RujoiRazvan/sistemAutomatDeIrigatie/README.md

# Sistem Automat de Irigatie
Proiect Informatică Aplicată II

Sistem Automat de Irigatie | Arduino

Componente utilizate
•	Arduino UNO

•	1 x Breadboard

•	Display Nokia 5110

•	Releu 5V Keyes

• Pompă submersibilă de apă 5V

•	Senzor de temperatură și umiditate DHT11

•	Senzor umiditate sol YL-69

•	Buzzer

•	Buton

•	Led Roșu 5mm

•	Rezistenta 10 kohm (albastra)

•	Rezistenta 200 ohm (albastra, la led)

•	Rezistenta 218 ohm (maro)

•	Modul NodeMcu WIFI ESP 8266 V3.0 (intreg proiectul poate fi realizat doar cu acest microcontroller, fara a mai folosi si Arduino Uno)

•	Cabluri mama – mama

•	Cabluri tata - tata

•	Cabluri mama – tata

•	Opțional – doză electrică 

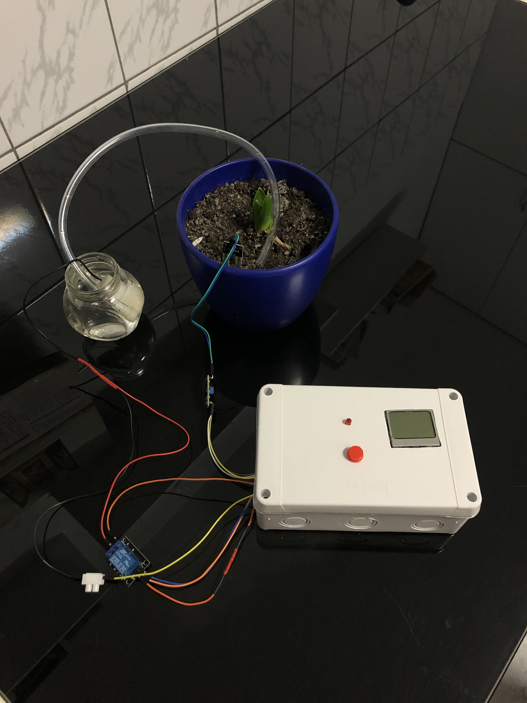
[picture p1: Poze proiect/2020-12-09 18.13.12 IMG_5424.JPG]
