RujoiRazvan/sistemAutomatDeIrigatie/Prezentare proiect.pdf

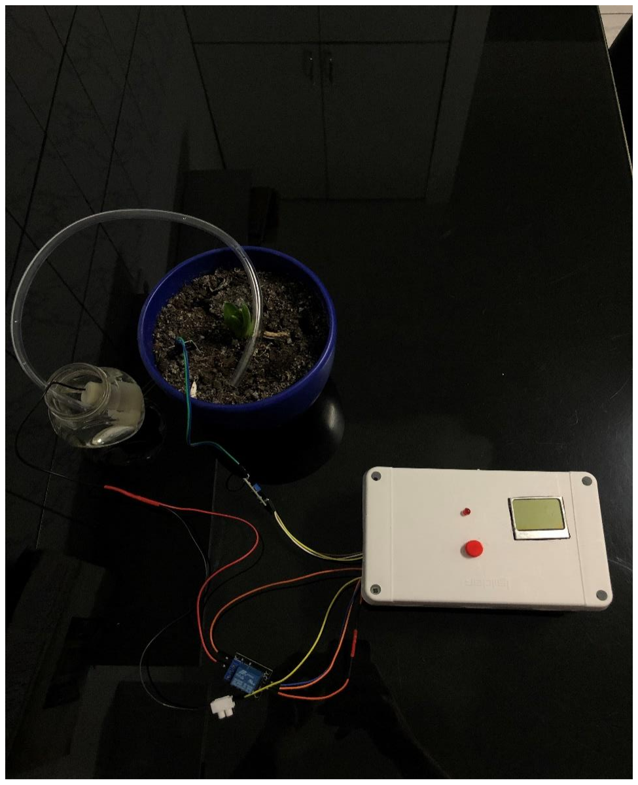
[picture p2: figure]

# Sistem automat de irigat

### ~ARDUINO UNO~

Rujoi Răzvan | Informatică Aplicată II | 31.10.2020

## Cuprins

## Componente utilizate

- Arduino UNO
- 1 sau 2 breadboard-uri
- Display Nokia 5110
- Releu 5V Keyes
- Pompă submersibilă de apă 5V
- Senzor de temperatură și umiditate DHT11
- Senzor umiditate sol YL-69
- Buzzer
- Buton
- Led Roșu 5mm
- Rezistență 10 kohm (albastră)
- Rezistență 200 ohm (albastră, la led)
- Rezistență 218 ohm (maro)
- Modul NodeMcu WIFI ESP 8266 V3.0
- Cabluri mamă – mamă
- Cabluri tată - tată
- Cabluri mamă – tată
- Opțional – doză electrică

Preț estimativ: 117lei.

## Utilitatea proiectului

Majoritate cred că avem flori sau ceva plante acasă, care trebuie udate. Problema e atunci când plecăm o perioadă mai lungă de acasă. M-am gândit să fac acest proiect cu scopul de a putea uda plantele de la distanță sau automat, la un anumit interval de timp, în funcție de umiditatea solului si de ce nu, si printr-o simplă apăsare a unui buton.

Pentru a putea adăuga proiectul intr-o carcasă, m-am decis să folosesc două breadbord-uri pentru a nu înghesui toate componentele pe o singură bază de construcție (breadboard). La un breadboard conectez senzorii iar la celălalt conectez tot ce ține de ieșirea datelor (display, led, difuzor), dar si butonul...care atunci când e apăsat, transmite un impuls electric și astfel pornește pompa

Aici (https://github.com/RujoiRazvan/sistemAutomatDeUdatPlante) se poate găsi întregul proiect .

## Realizarea proiectului

1. CONECTAREA TUTUROR COMPONENTELOR

Începem cu legarea GND-ului si VCC-ului (5V în cazul nostru) la primul breadboard. Pe tot parcusul proiectului am folosit acealeași culori pentru GND si VCC, mai exact negru respectiv roșu.

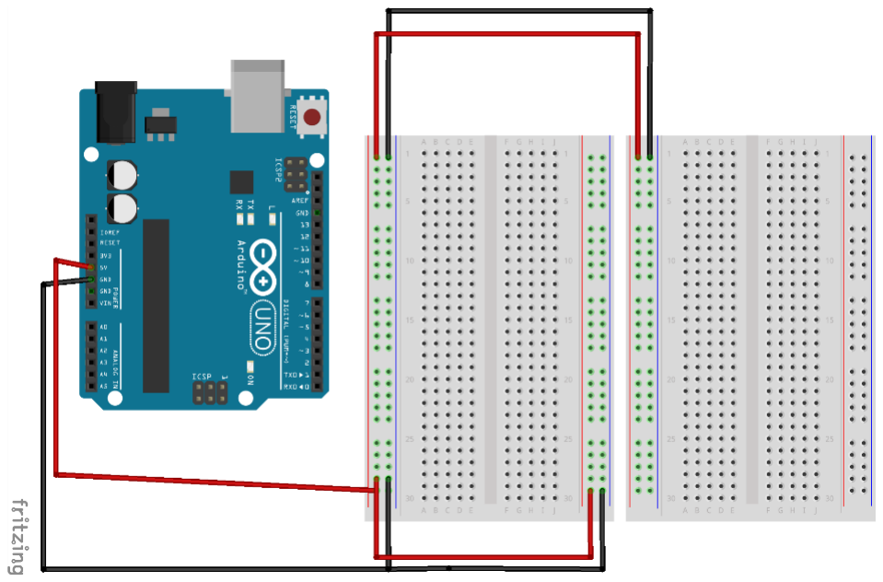
[picture p3: figure]

O să continuăm cu adăugarea senzorilor (la primul breadboard).

Conectăm senzorul DHT11. Acesta are 3 pini: GND, VCC si S. Primii doi pini se conectează la fel ca în cazul breadboard-ului iar pinul S, cel care transmite datele către Arduino se conectează la pinul Digital nr. 2 de pe Arduino (cablul alb).

Figura 1.0

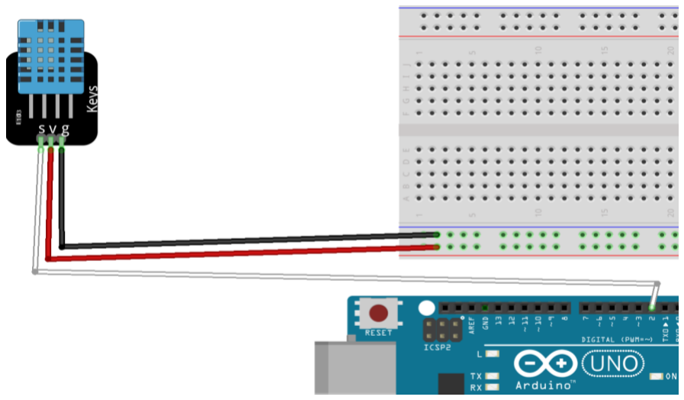
[picture p4: figure]

Figura 1.1

Conectăm buzzer-ul. Acesta are doar 2 pini: GND și VCC. Pentru a putea controla când să pornească, o să conectăm VCC-ul la pinul Digital nr. 6 astfel: conectăm VCC-ul la un pin de pe breadboard iar la un pin aflat pe aceeași linie, conectăm un alt cablu care o sa meargă la pinul Digital nr. 6.

GND-ul o să-l conectăm folosind o rezistență de 218 ohm.

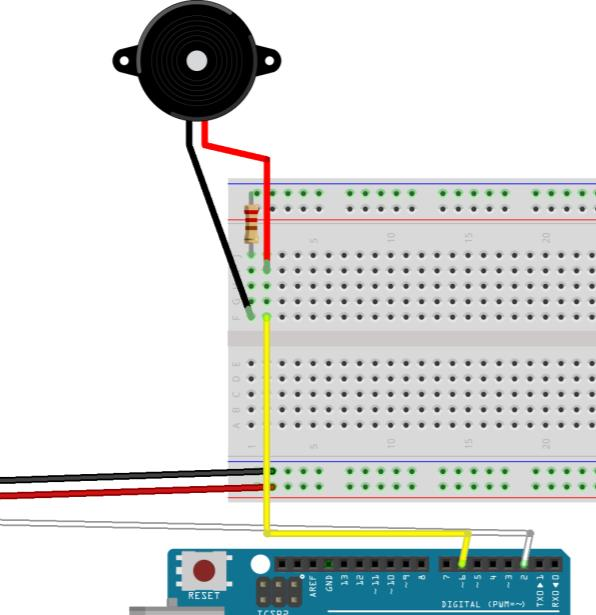
[picture p5: figure]

Senzorul de umiditate a solului are 4 pini. VCC-ul si GND-ul se conecteaza la breadboard iar pinul de semnal (eu am ales pinul pentru semnal Analog) il conectez la pinul A0 de pe Arduino.

Pompa de apă trebuie conectată folosind un releu și tot odată trebuie conectată la o sursă de curent (în cazul meu, o baterie de 9V) .Minisul îl conectăm direct la baterie iar plusul îl conectăm la portul NO (Normally Open).

Acum urmează să conectăm releul la Arduino. De data aceasta am conectat releul direct la Arduino pentru că l-am conectat direct la breadboard dar apoi nu imi mai mergea display-ul. VCC-ul l-am conectat la 5V, GND-ul la GND și pinul S (de la Signal) l-am conectat la pinul Digital nr. 4, dar folosind și o rezistență de 10 kohm. Am folosit acea rezistență deoarece atunci când porneam pompa, Arduino-ul se reseta sau pompa nu mergea așa cum trebuia. (vezi video) (https://youtu.be/gzFHKmYkRg8)

Figura 1.2

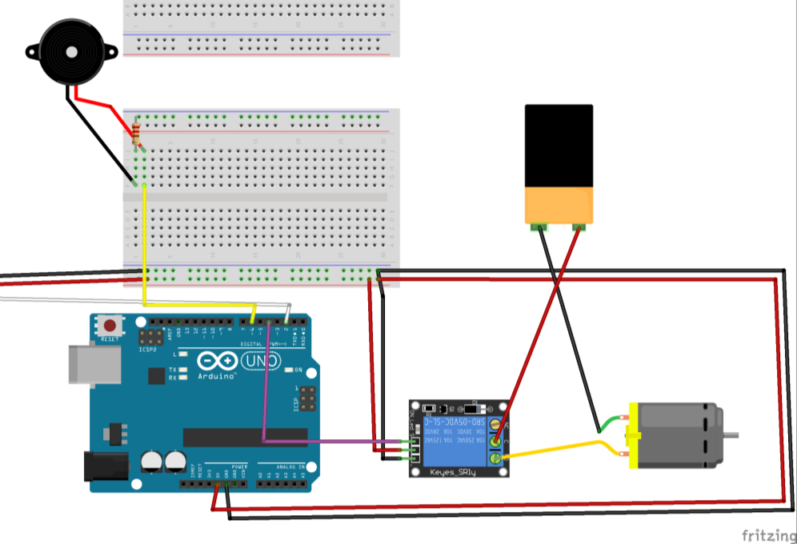
[picture p6: figure]

Figura 1.3

Acum urmează să lucrăm la cel de al doilea breadboard.
O să începem cu conectarea display-ului de Nokia 5110. Este un display 84x48. Display-ul are 8 pini. VCC-ul si GND-ul se conectează ca până acum. Aproape toate legăturile le-am făcut folosind primul breadboard pentru a putea manipula cât mai ușor breadboardul cu display-ul, butonul etc.. Backlight-ul l-am conectat tot la GND, dar folosind o rezistență de 10 kohm. Restul pinilor i-am conectat astfel:
- SCE – pinul 9
- RST – pinul 8
- D/C – pinul 10
- DN – pinul 11
- SCLK – pinul 12

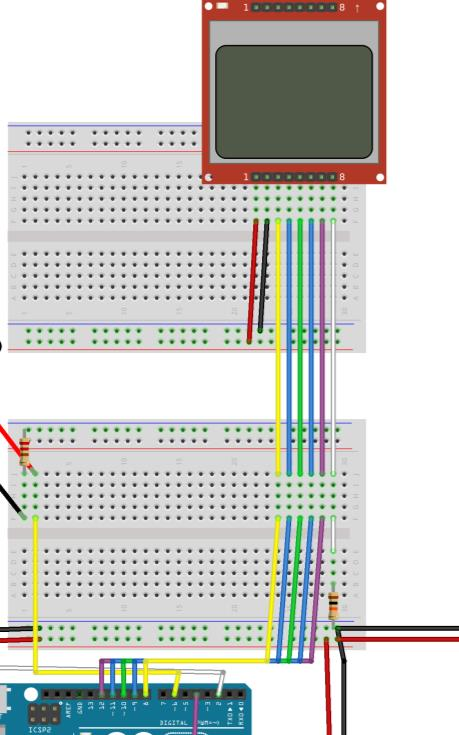
[picture p7: figure]

Figura 1.4

Mai adăugăm un led, eu am ales unul roșu de 5mm și un buton (de tipul push button) de la care pornim manual pompa.

Led-ul îl conectăm foarte ușor. Catodul (piciorușul mai scurt) îl conectăm la GND. Anodul (piciorușul mai lung) il conectăm la pinul Digital nr. 7, prin intermediul breadboardului 1 dar si la VCC, de data aceasta folosind o rezistență de 200 ohm pentru a nu-l arde. Led-ul de 5mm funcționează la un voltaj intre 1.8V si 2.4V. Noi având breadboardul conectat la 5V, avem nevoie de o rezistență pentru a limita cantitatea de curent care trece prin el si astfel prelungindui durata de viață (cu această rezistență am pe led o tensiune de 1.93V).

Butonul l-am conectat la GND cu o rezistență de 10kohm pentru a nu prelua orice impuls mic de curent care ar fi pornit pompa de apă. De la același pin al butonului, am dus un fir la pinul Digital nr. 5.

Ultima componentă care trebuie conectată e modulul wifi NodeMcu V3, cu ajutorul căruia o să pornim pompa de apă prin wifi sau. Îl conectăm la VCC folosind pinul 3.3V de pe modul, din care ducem un fir la + ul de pe breadboard, iar GND-ul la – ul de pe breadboard. Din pinul D2 ducem un fir la pinul butonului (vezi schema). Pentru a afișa temperatura in aplicația Blynk, am tras un fir de la Signal (DHT11) la pinul D4 de pe NodeMcu.

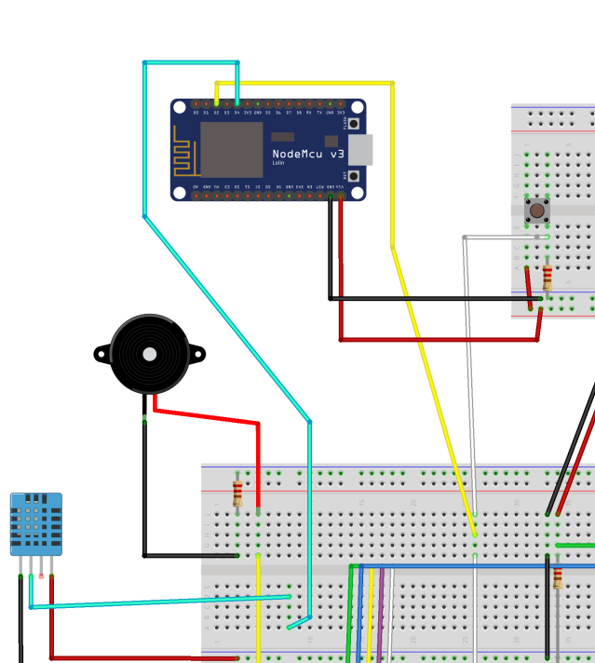
[picture p8: figure]

Figura 1.5

P.S.: Am renunțat la breadbordul nr. 2 pentru a putea lipi lcd-ul, led-ul si butonul pe aceea carcasă.

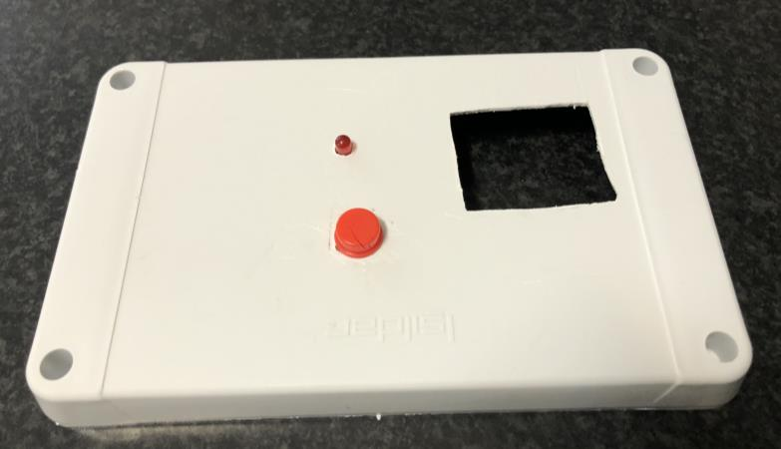
[picture p9: figure]

Prin urmare, am lipit rezistența direct pe led iar pe buton am lipit două fire.

Capac carcasă

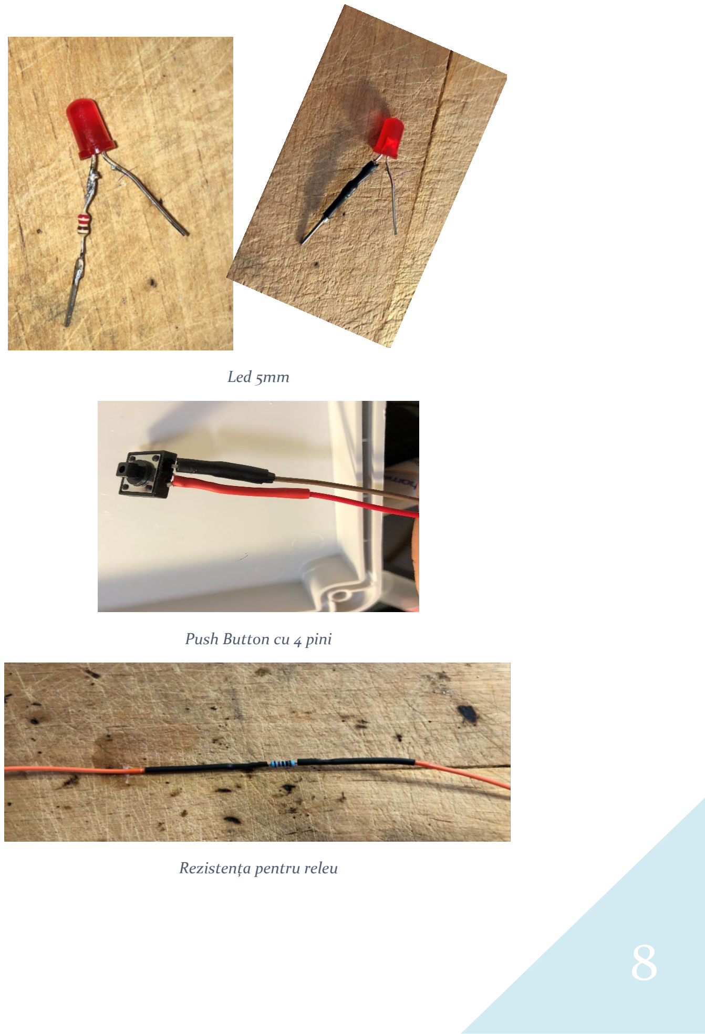
[picture p10: page 9]

Led 5mm

Push Button cu 4 pini

Rezistența pentru releu

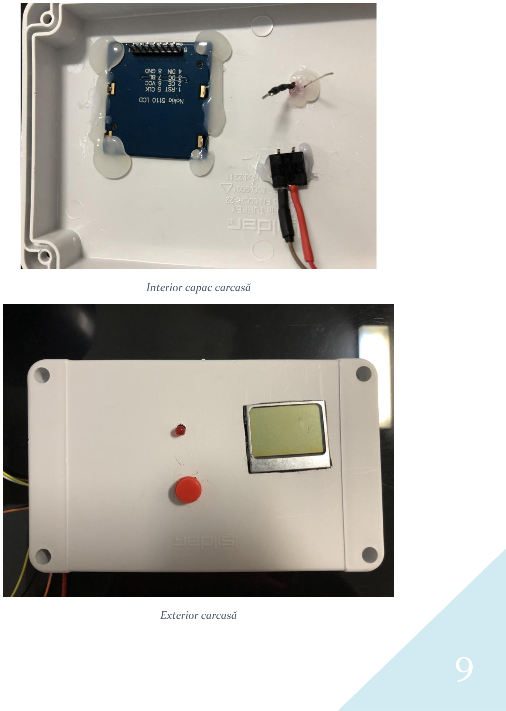
[picture p11: page 10]

Interior capac carcasă

Exterior carcasă

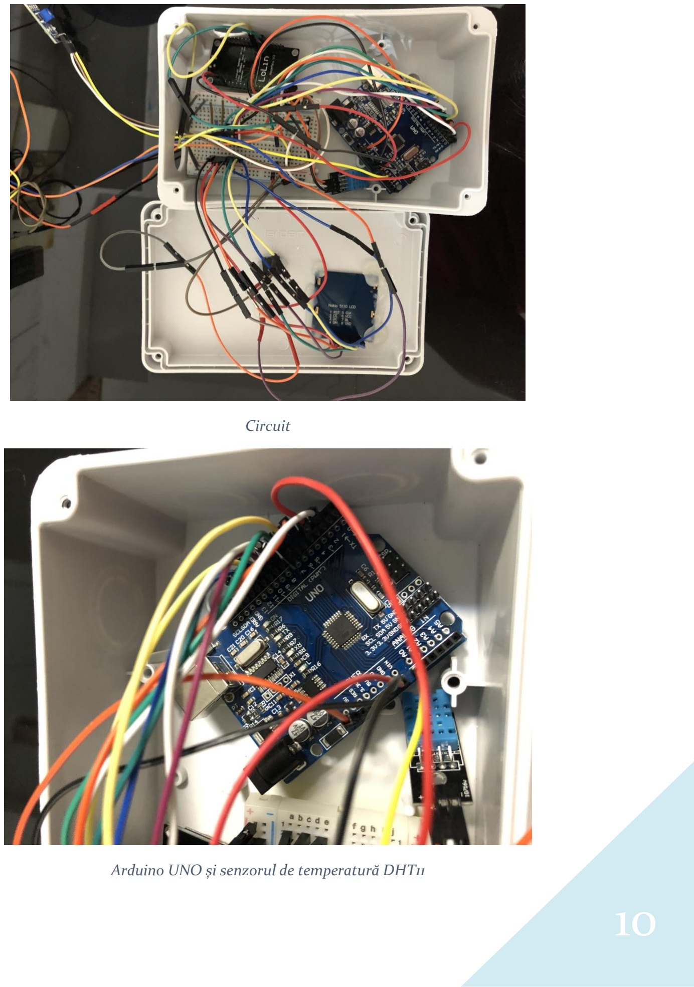
[picture p12: page 11]

Circuit

Arduino UNO și senzorul de temperatură DHT11

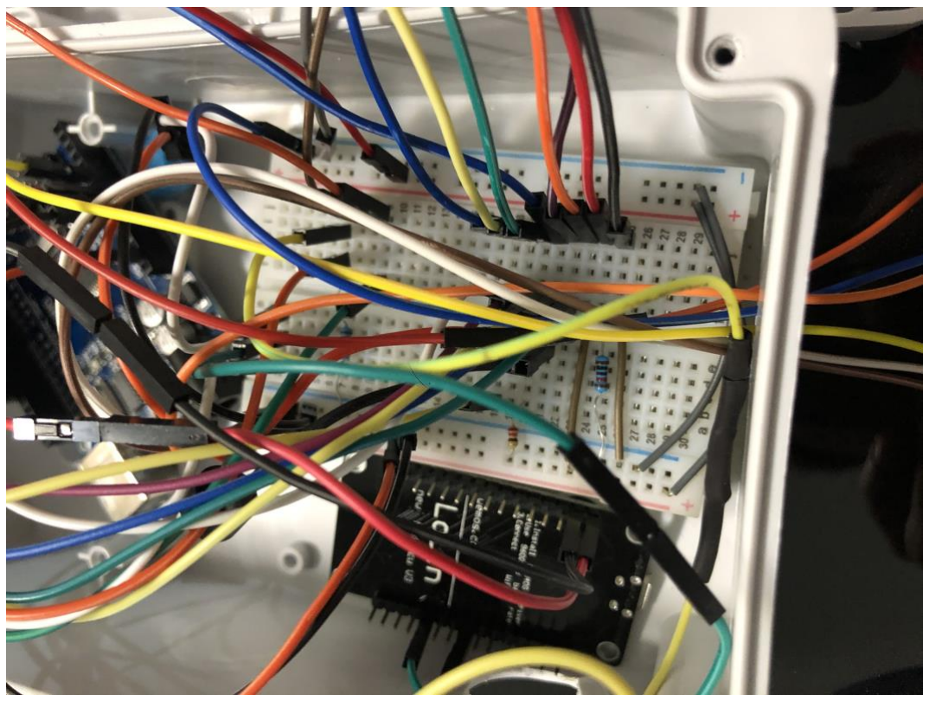
[picture p13: figure]

Modul Wifi NodeMCU V3.0 și breadboard

2. SCRIEREA CODULUI

Prima dată trebuie să instalăm Arduino IDE (https://www.arduino.cc/en/software).

O să începem prin adăugarea librăriilor. Avem nevoie doar de două librării:

- pentru display-ul Nokia 5110 (https://github.com/RujoiRazvan/sistemAutomatDeUdatPlante/blob/main/Adafruit-PCD8544-Nokia-5110-LCD-library-master.rar)
- pentru senzorul de temperatură DHT11 (https://github.com/RujoiRazvan/sistemAutomatDeUdatPlante/blob/main/DHTlib.rar)

Programul e structurat in două funcții: setup() și loop().

În setup() facem pinilor și inițializarea display-ului pentru prima pornire.

În funcția loop() scriem comenziile pe care vrem ca Arduino să le execute în mod repetitiv.

Vizualizează codul (https://github.com/RujoiRazvan/sistemAutomatDeUdatPlante/blob/main/Sistem_Automat_de_Udat_Plante.ino)

Pentru a putea controla pompa de pe telefon, avem nevoie să programăm modulul Wifi NodeMCU ESP8266 V3.0. Acest modul poate fi folosit și standalone dar aici îl folosim pentru a activa butonul fizic, care e legat la Arduino iar astfel se execute toate celălalte comenzi. Codul l-am generator automat pe acest (https://examples.blynk.cc/?board=ESP8266&shield=ESP8266%20WiFi&example=More%2FDHT11) site. Apoi am instalat aplicația Blynk pe telefon, am creat un proiect și am primit pe mail un autentificator pe care l-am adăugat în programul generat.

Vizualizează codul (https://github.com/RujoiRazvan/sistemAutomatDeUdatPlante/blob/main/ESP8266_Standalone.ino)

## Videoclipuri

- Pornire pompă de la buton (https://youtu.be/zWD_Jf1BwbU)
- Pornire pompă prin aplicația Blynk (https://youtu.be/5VBfaCA5-UU)
- Modificarea umidității solului (https://youtu.be/xtvZwhrjj-I)

## Bibliografie

- https://lastminuteengineers.com/nokia-5110-lcd-arduino-tutorial/
- https://www.instructables.com/Simple-Led-Control-With-Blynk-and-NodeMCU-Esp8266-/ (https://www.instructables.com/Simple-Led-Control-With-Blynk-and-NodeMCU-Esp8266-/)
- https://www.youtube.com/watch?v=udmJyncDvw0&ab_channel=AndreasSpiess
- https://www.instructables.com/Arduino-Soil-Moisture-Sensor/
- https://forum.arduino.cc/
