RujoiRazvan/sistemAutomatDeIrigatie/Poze proiect/2020-12-09 18.10.22 IMG_5423.JPG

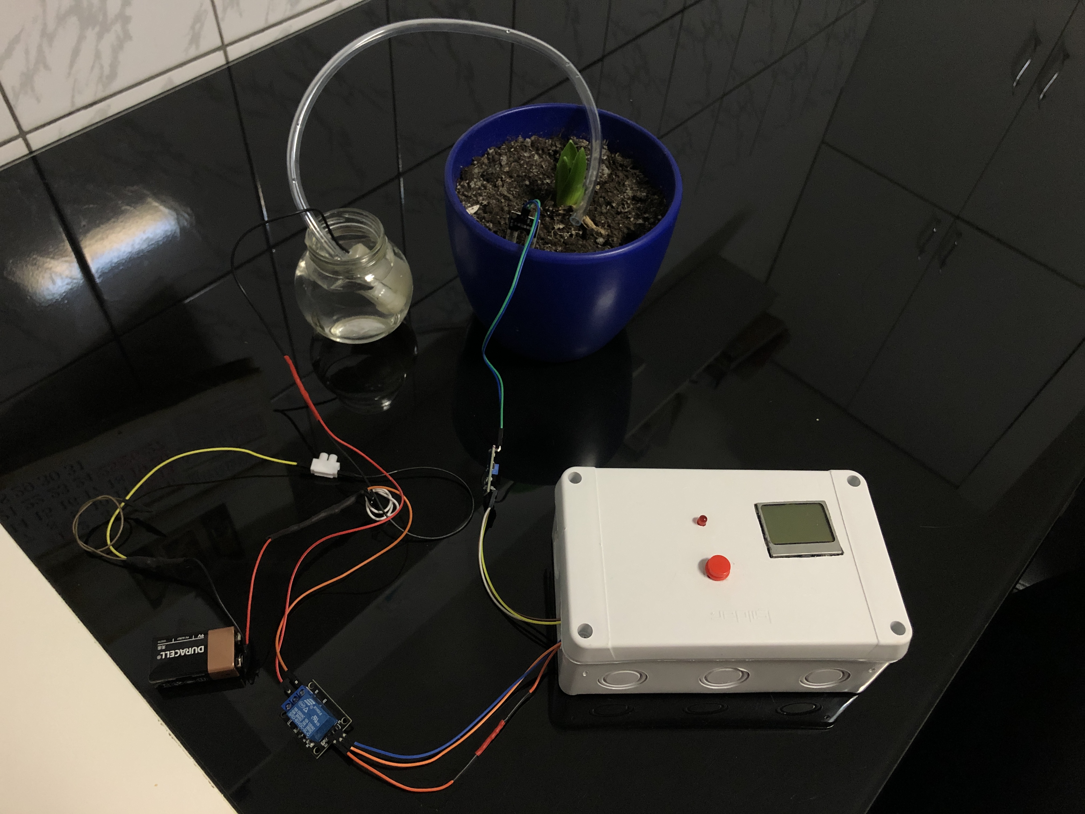
Poze proiect/2020-12-09 18.10.22 IMG_5423.JPG
