RujoiRazvan/sistemAutomatDeIrigatie/Poze proiect/2020-12-09 18.13.24 IMG_5425.JPG

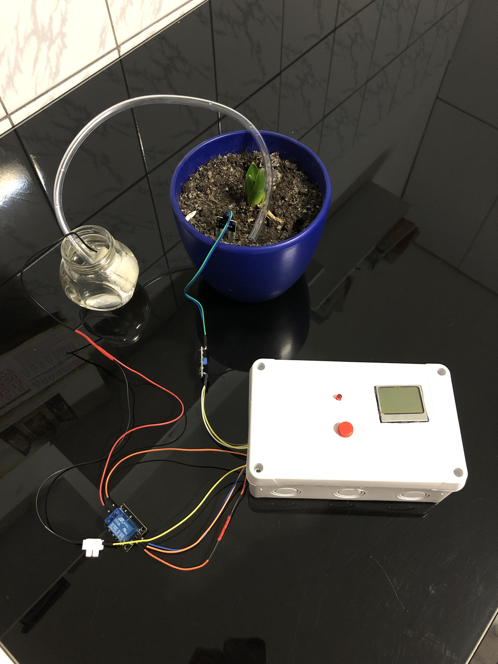
Poze proiect/2020-12-09 18.13.24 IMG_5425.JPG
