RujoiRazvan/sistemAutomatDeIrigatie/Poze proiect/2020-12-09 18.13.29 IMG_5426.JPG

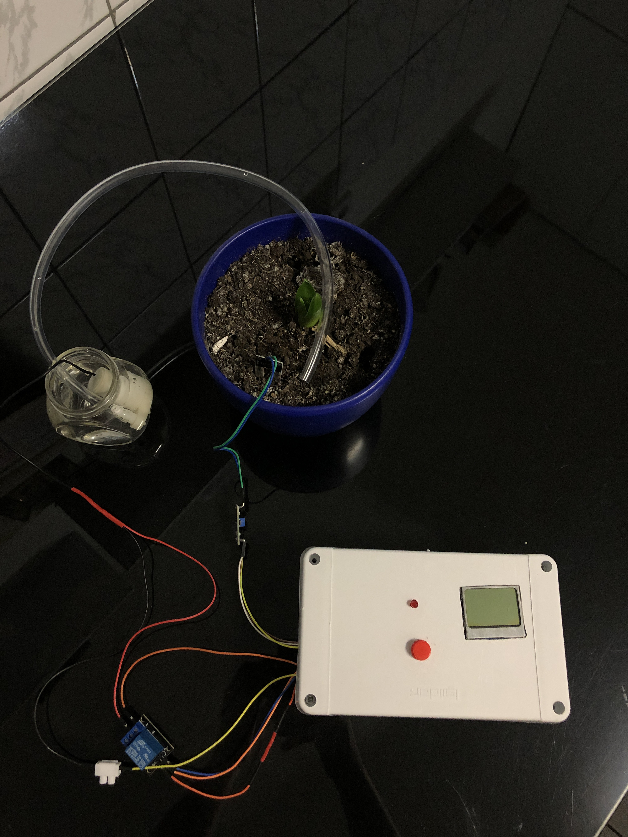
Poze proiect/2020-12-09 18.13.29 IMG_5426.JPG
