RujoiRazvan/sistemAutomatDeIrigatie/Poze proiect/2020-12-09 18.13.46 IMG_5427.JPG

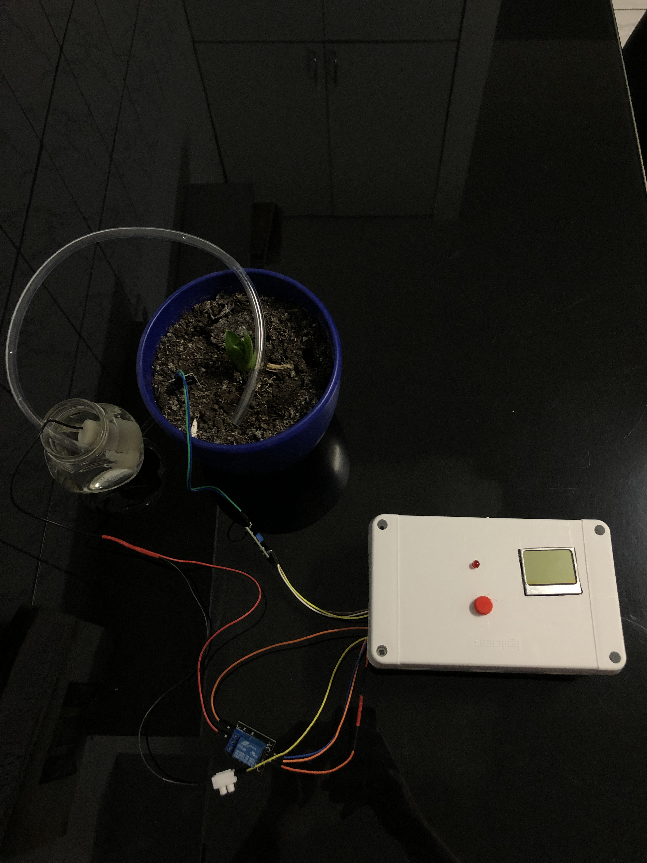
Poze proiect/2020-12-09 18.13.46 IMG_5427.JPG
