RujoiRazvan/sistemAutomatDeIrigatie/Poze proiect/2020-12-09 18.13.53 IMG_5428.JPG

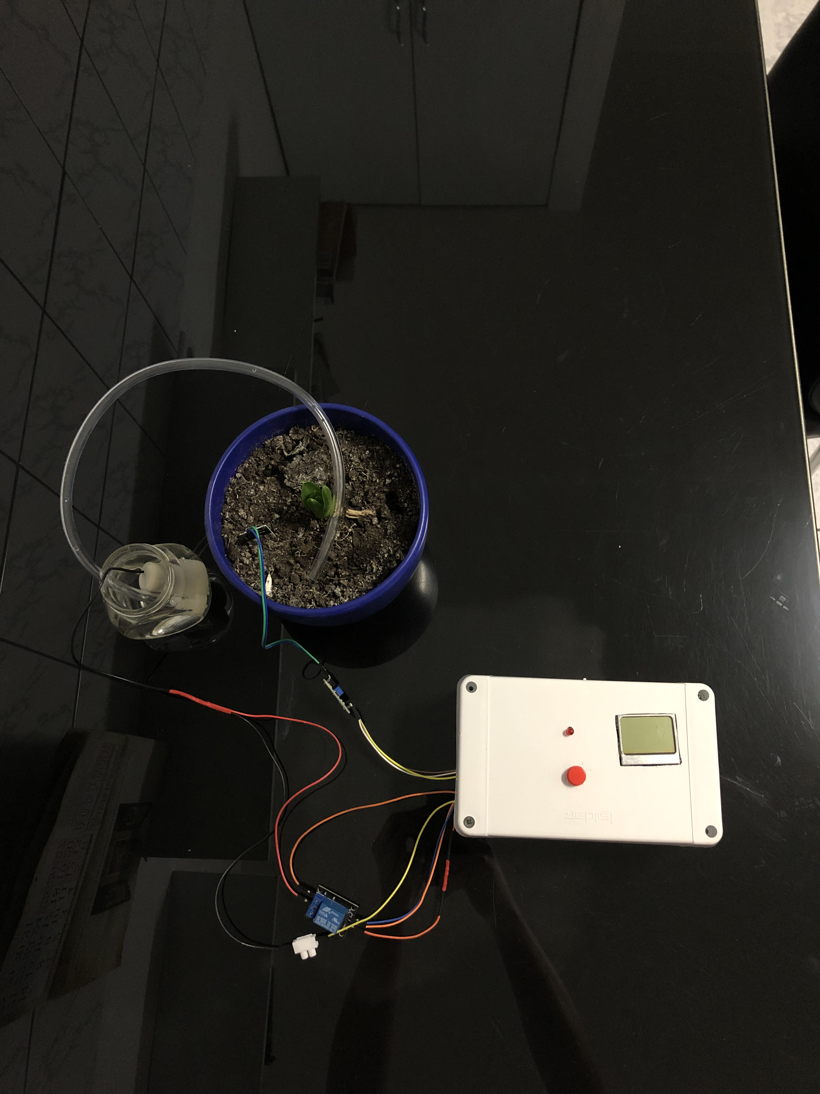
Poze proiect/2020-12-09 18.13.53 IMG_5428.JPG
