RujoiRazvan/sistemAutomatDeIrigatie/Poze proiect/2020-12-09 18.14.02 IMG_5429.JPG

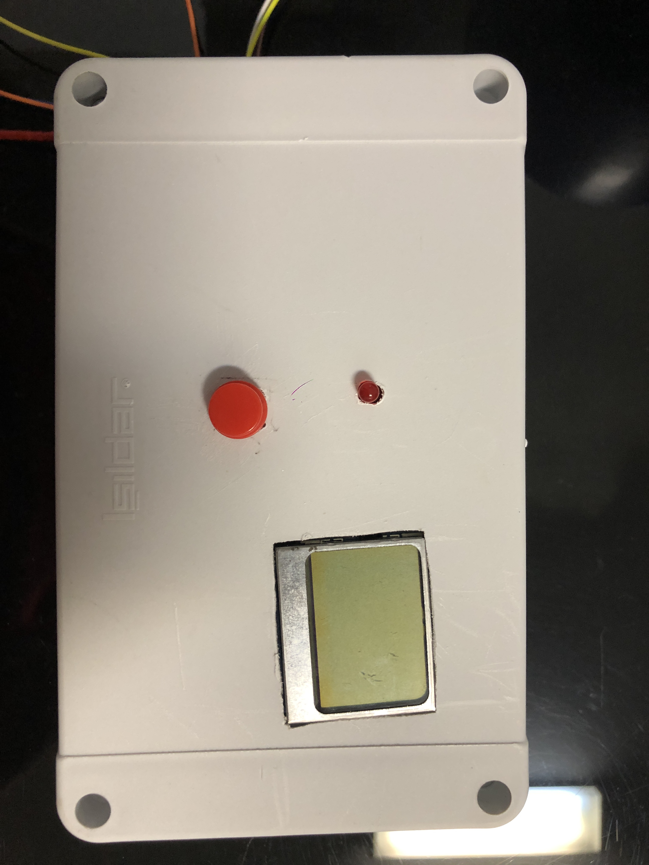
Poze proiect/2020-12-09 18.14.02 IMG_5429.JPG
