RujoiRazvan/sistemAutomatDeIrigatie/Poze proiect/2020-12-09 18.30.20 IMG_5431.JPG

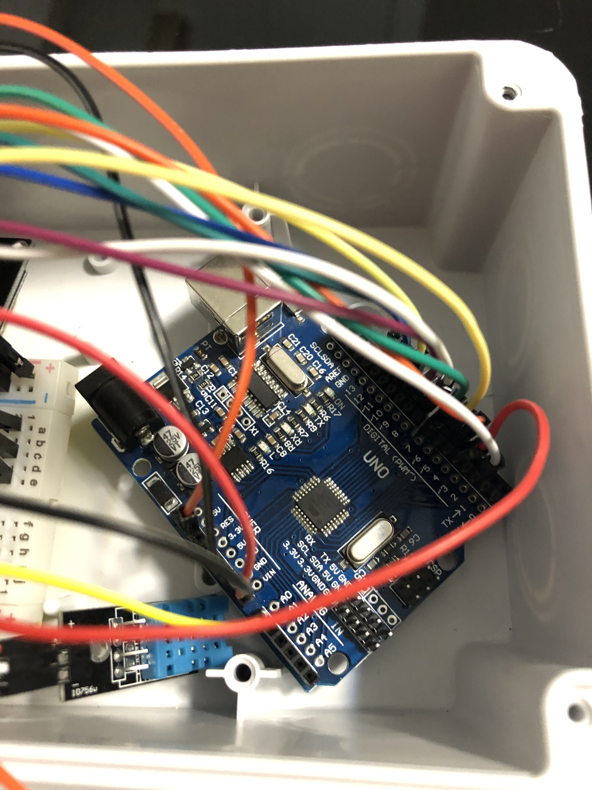
Poze proiect/2020-12-09 18.30.20 IMG_5431.JPG
