RujoiRazvan/sistemAutomatDeIrigatie/Poze proiect/2020-12-09 18.30.45 IMG_5432.JPG

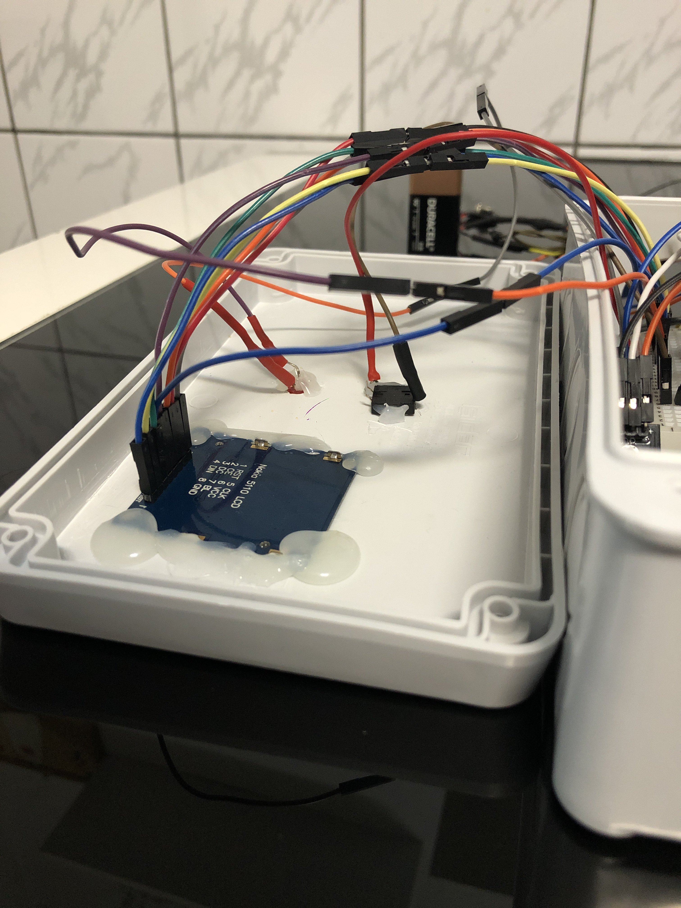
Poze proiect/2020-12-09 18.30.45 IMG_5432.JPG
