RujoiRazvan/sistemAutomatDeIrigatie/Poze proiect/2020-12-09 18.30.50 IMG_5433.JPG

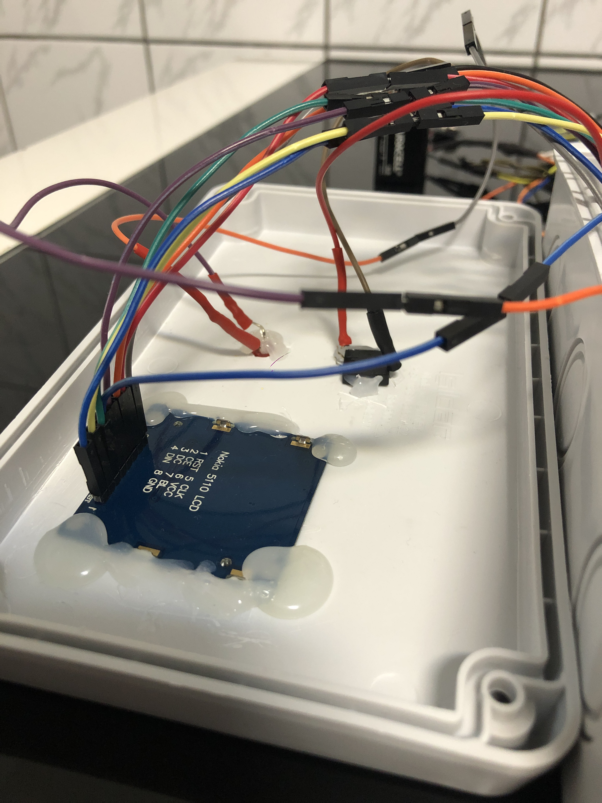
Poze proiect/2020-12-09 18.30.50 IMG_5433.JPG
