RujoiRazvan/sistemAutomatDeIrigatie/Poze proiect/2020-12-09 18.30.00 IMG_5430.JPG

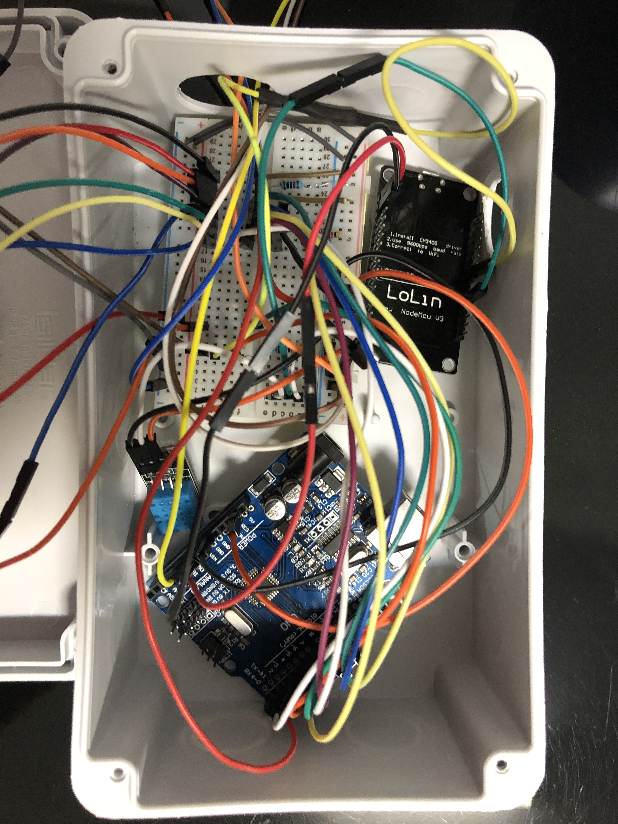
Poze proiect/2020-12-09 18.30.00 IMG_5430.JPG
