RujoiRazvan/sistemAutomatDeIrigatie/Poze proiect/2020-12-09 18.31.02 IMG_5434.JPG

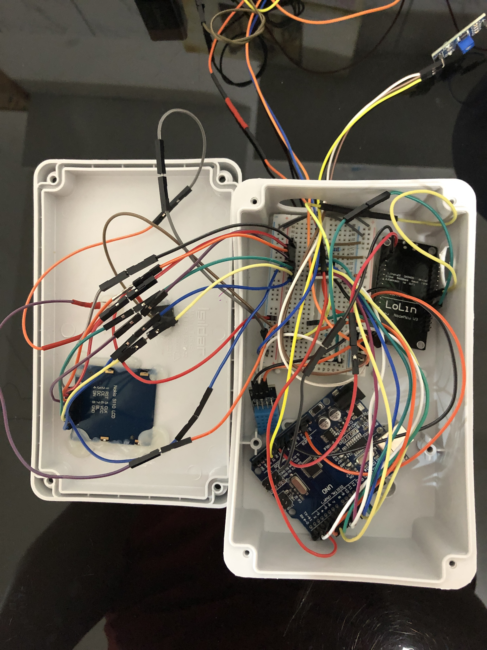
Poze proiect/2020-12-09 18.31.02 IMG_5434.JPG
