RujoiRazvan/sistemAutomatDeIrigatie/Poze proiect/2020-12-09 18.31.31 IMG_5435.JPG

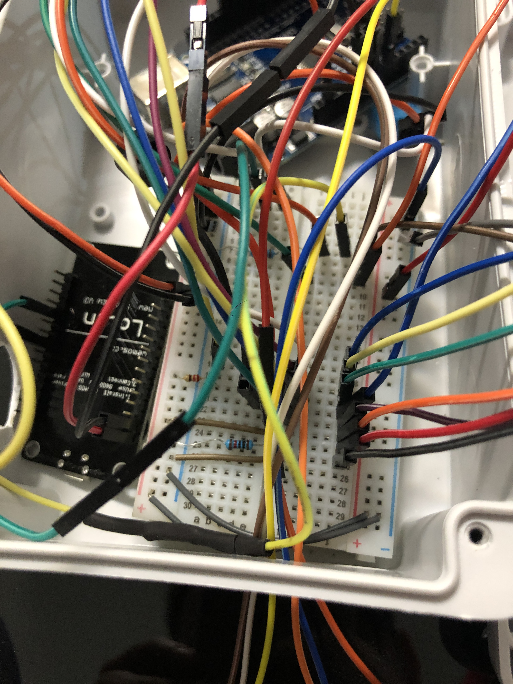
Poze proiect/2020-12-09 18.31.31 IMG_5435.JPG
