RujoiRazvan/sistemAutomatDeIrigatie/Poze proiect/2020-12-09 18.31.40 IMG_5436.JPG

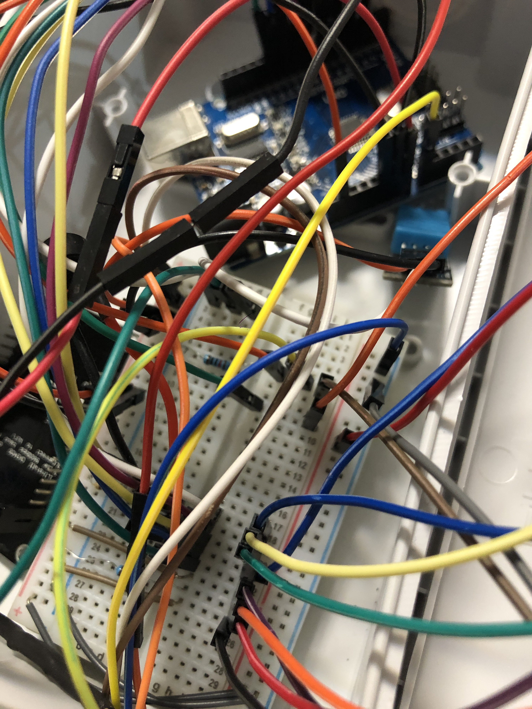
Poze proiect/2020-12-09 18.31.40 IMG_5436.JPG
